minisystem/820/Panel/820_panel.png

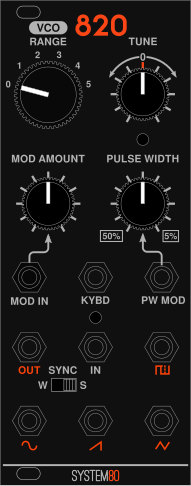
Panel/820_panel.png
