minisystem/820/Panel/Ward-Beck/820_panel_dimensioned.dxf

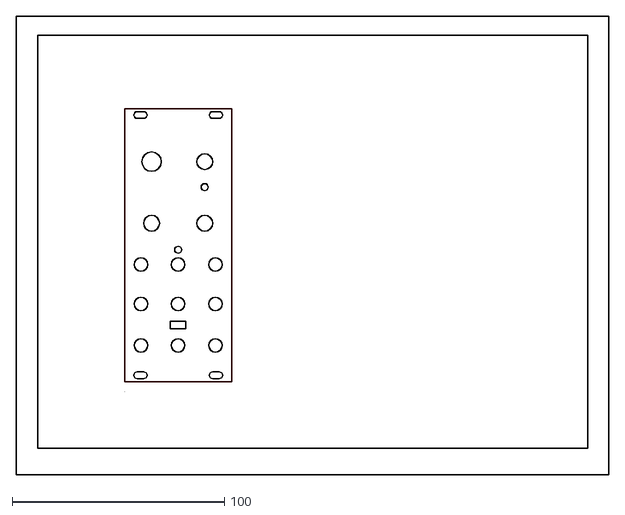
[picture p2: CAD file, 2019-03-22]
Panel/Ward-Beck/820_panel_dimensioned.dxf
279.0 x 216.0
