minisystem/820/panel_template.dxf

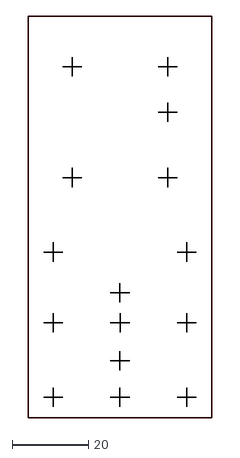
[picture p3: CAD file, 2018-07-26]
panel_template.dxf
48.0 x 105.0
