minisystem/820/(list of files, cad)

Other CAD files:
Panel/820_panel.dxf
Panel/820_panel_dimensioned.dwg
Panel/Ward-Beck/820_panel_dimensioned_R2000-2002.dwg
Panel/820_panel.dwg
Panel/Ward-Beck/820_panel_dimensioned.dwg
