minisystem/820/Panel/Ward-Beck/820_overview.pdf

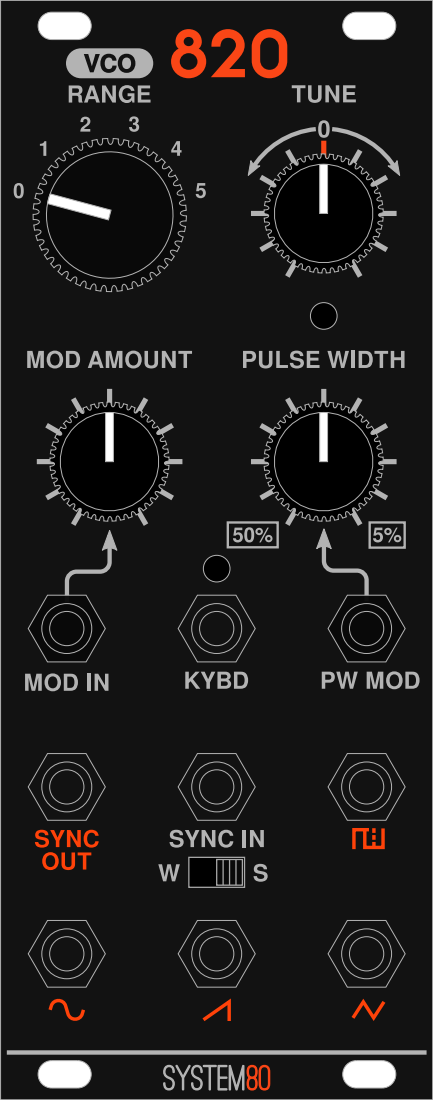
[picture p4: page 1]
