minisystem/820/Gerbers/820-Eco1.User.pdf

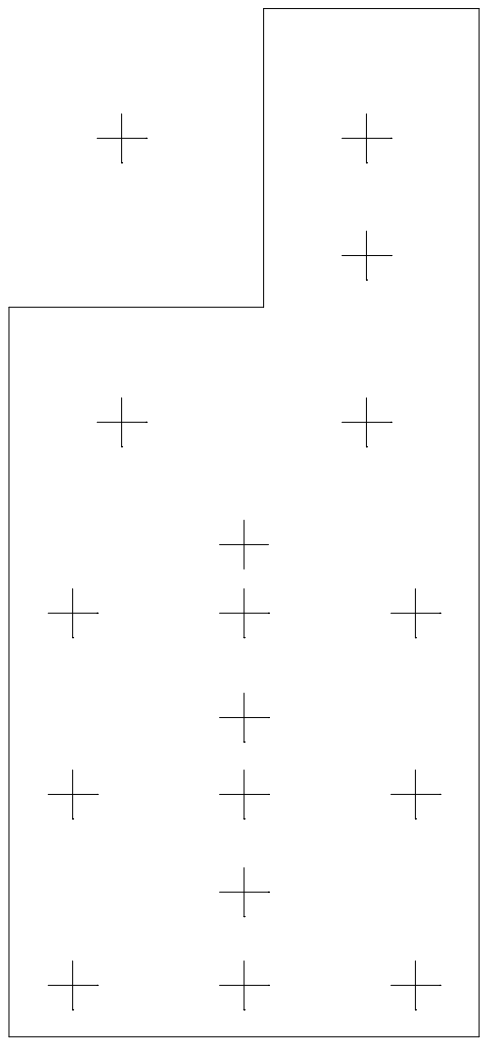
[picture p5: page 1]
