minisystem/820/Panel/Ward-Beck/820_artwork_grey.pdf

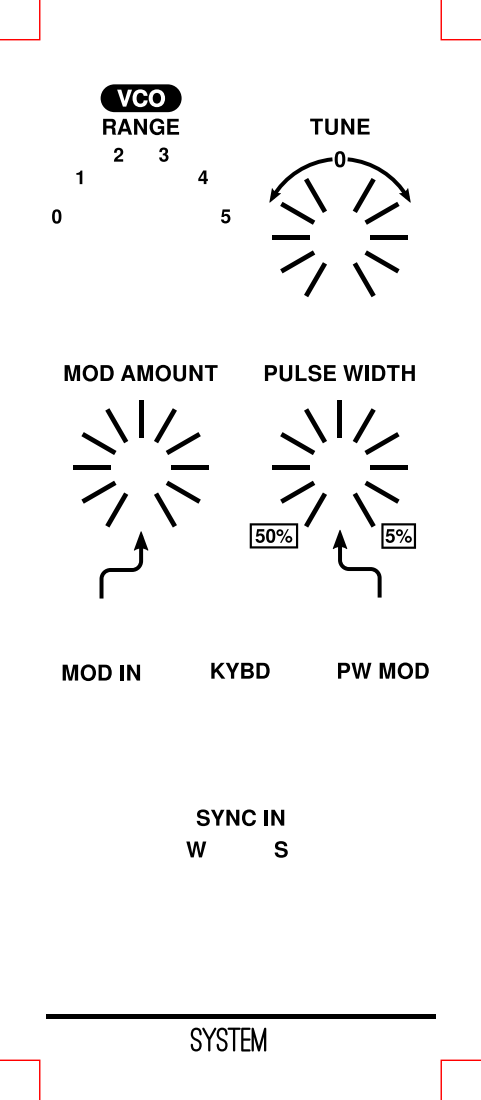
[picture p6: page 1]
