minisystem/820/Panel/Ward-Beck/820_artwork_orange.pdf

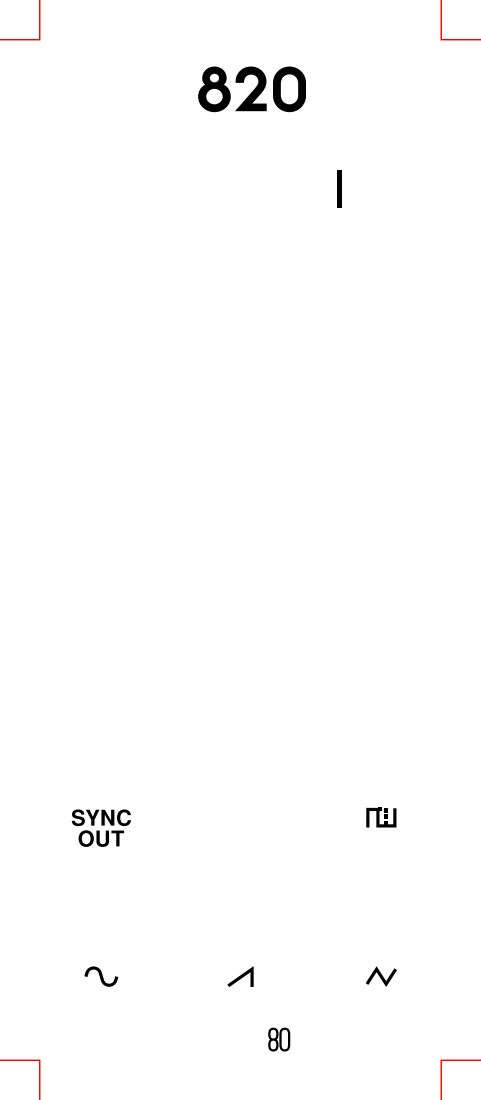
[picture p7: page 1]
