minisystem/820/Panel/Ward-Beck/820_panel_dimensioned.pdf

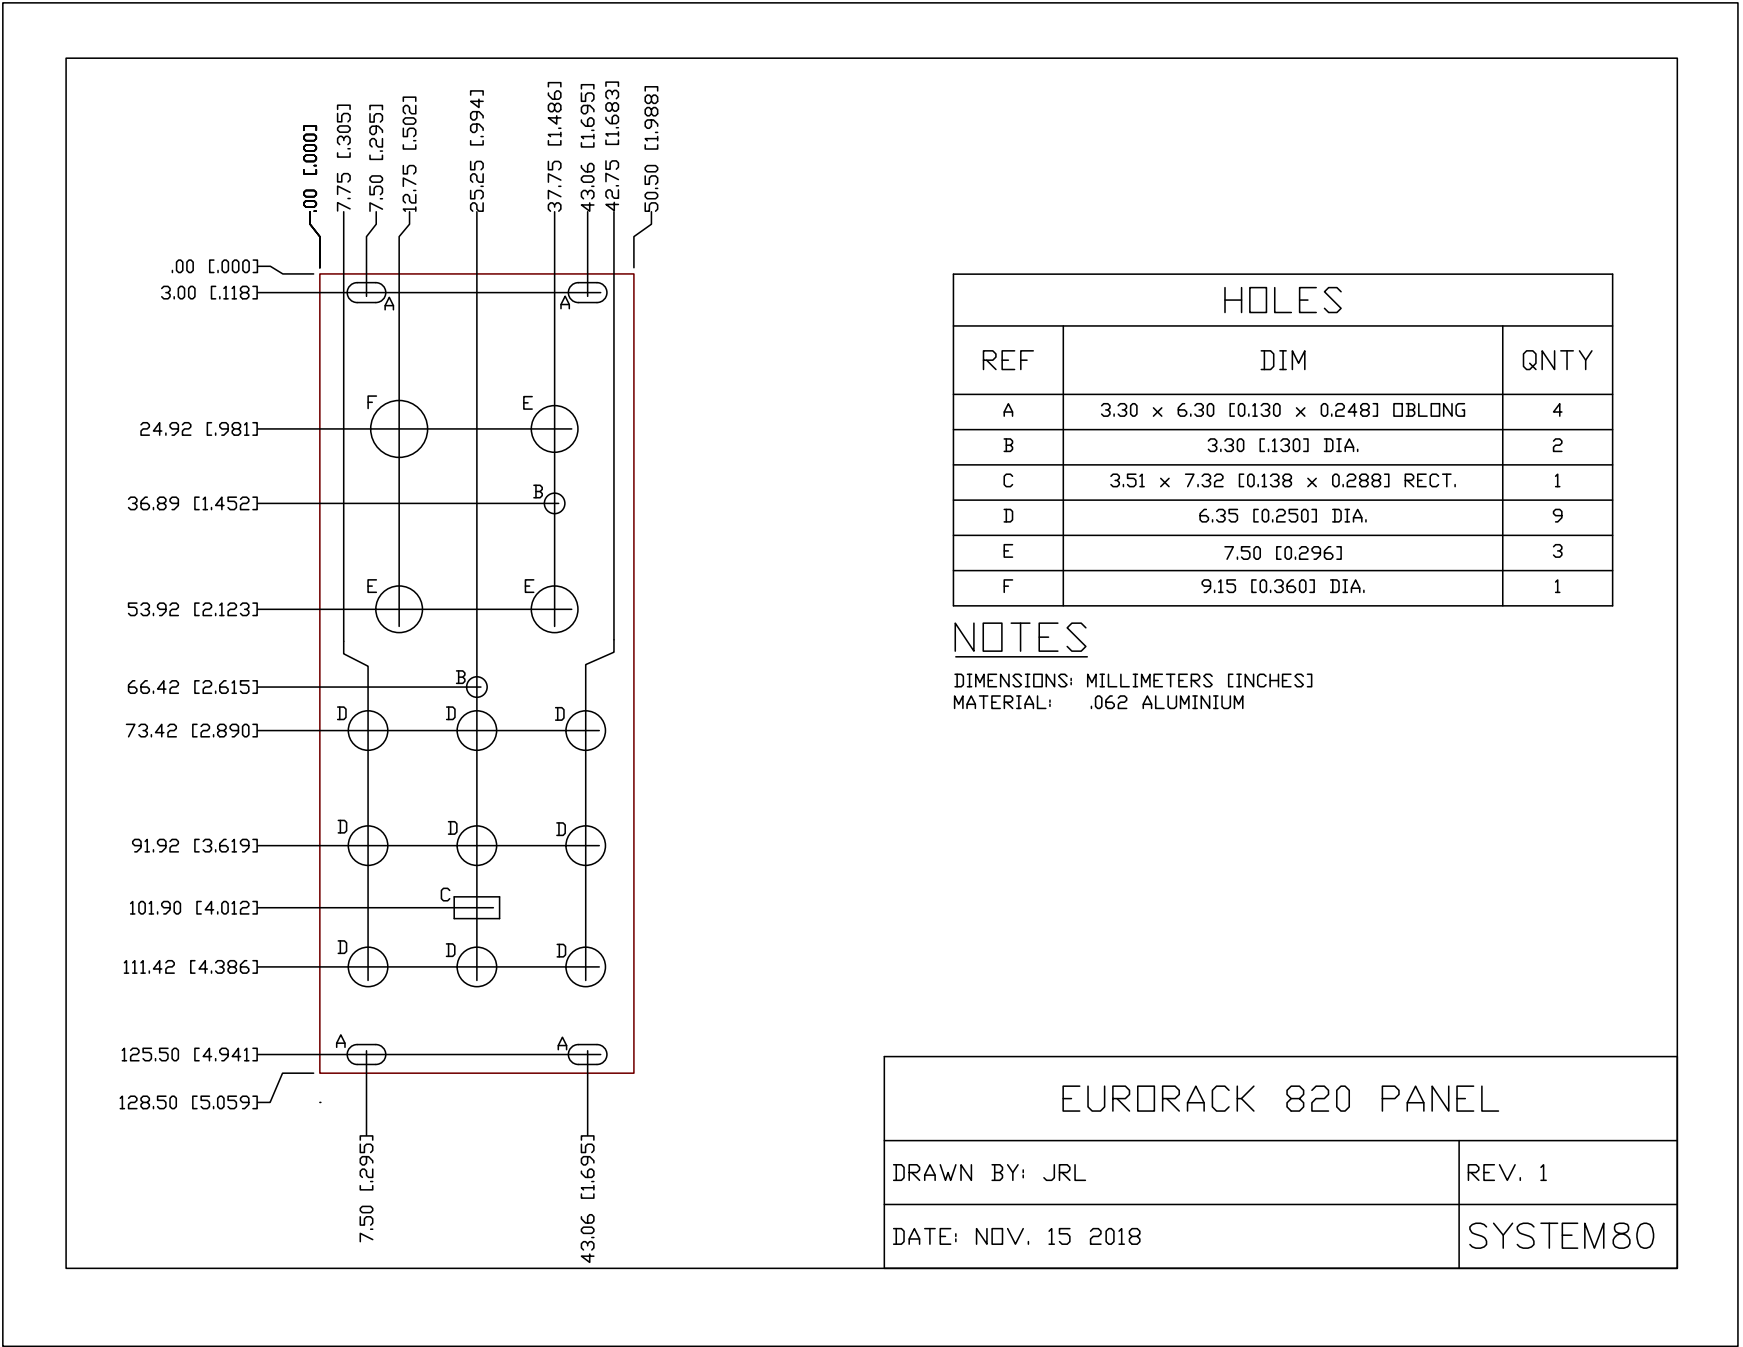
[picture p8: page 1]
