minisystem/820/820.kicad_pcb

## KiCad design 820.kicad_pcb (2019-04-12)

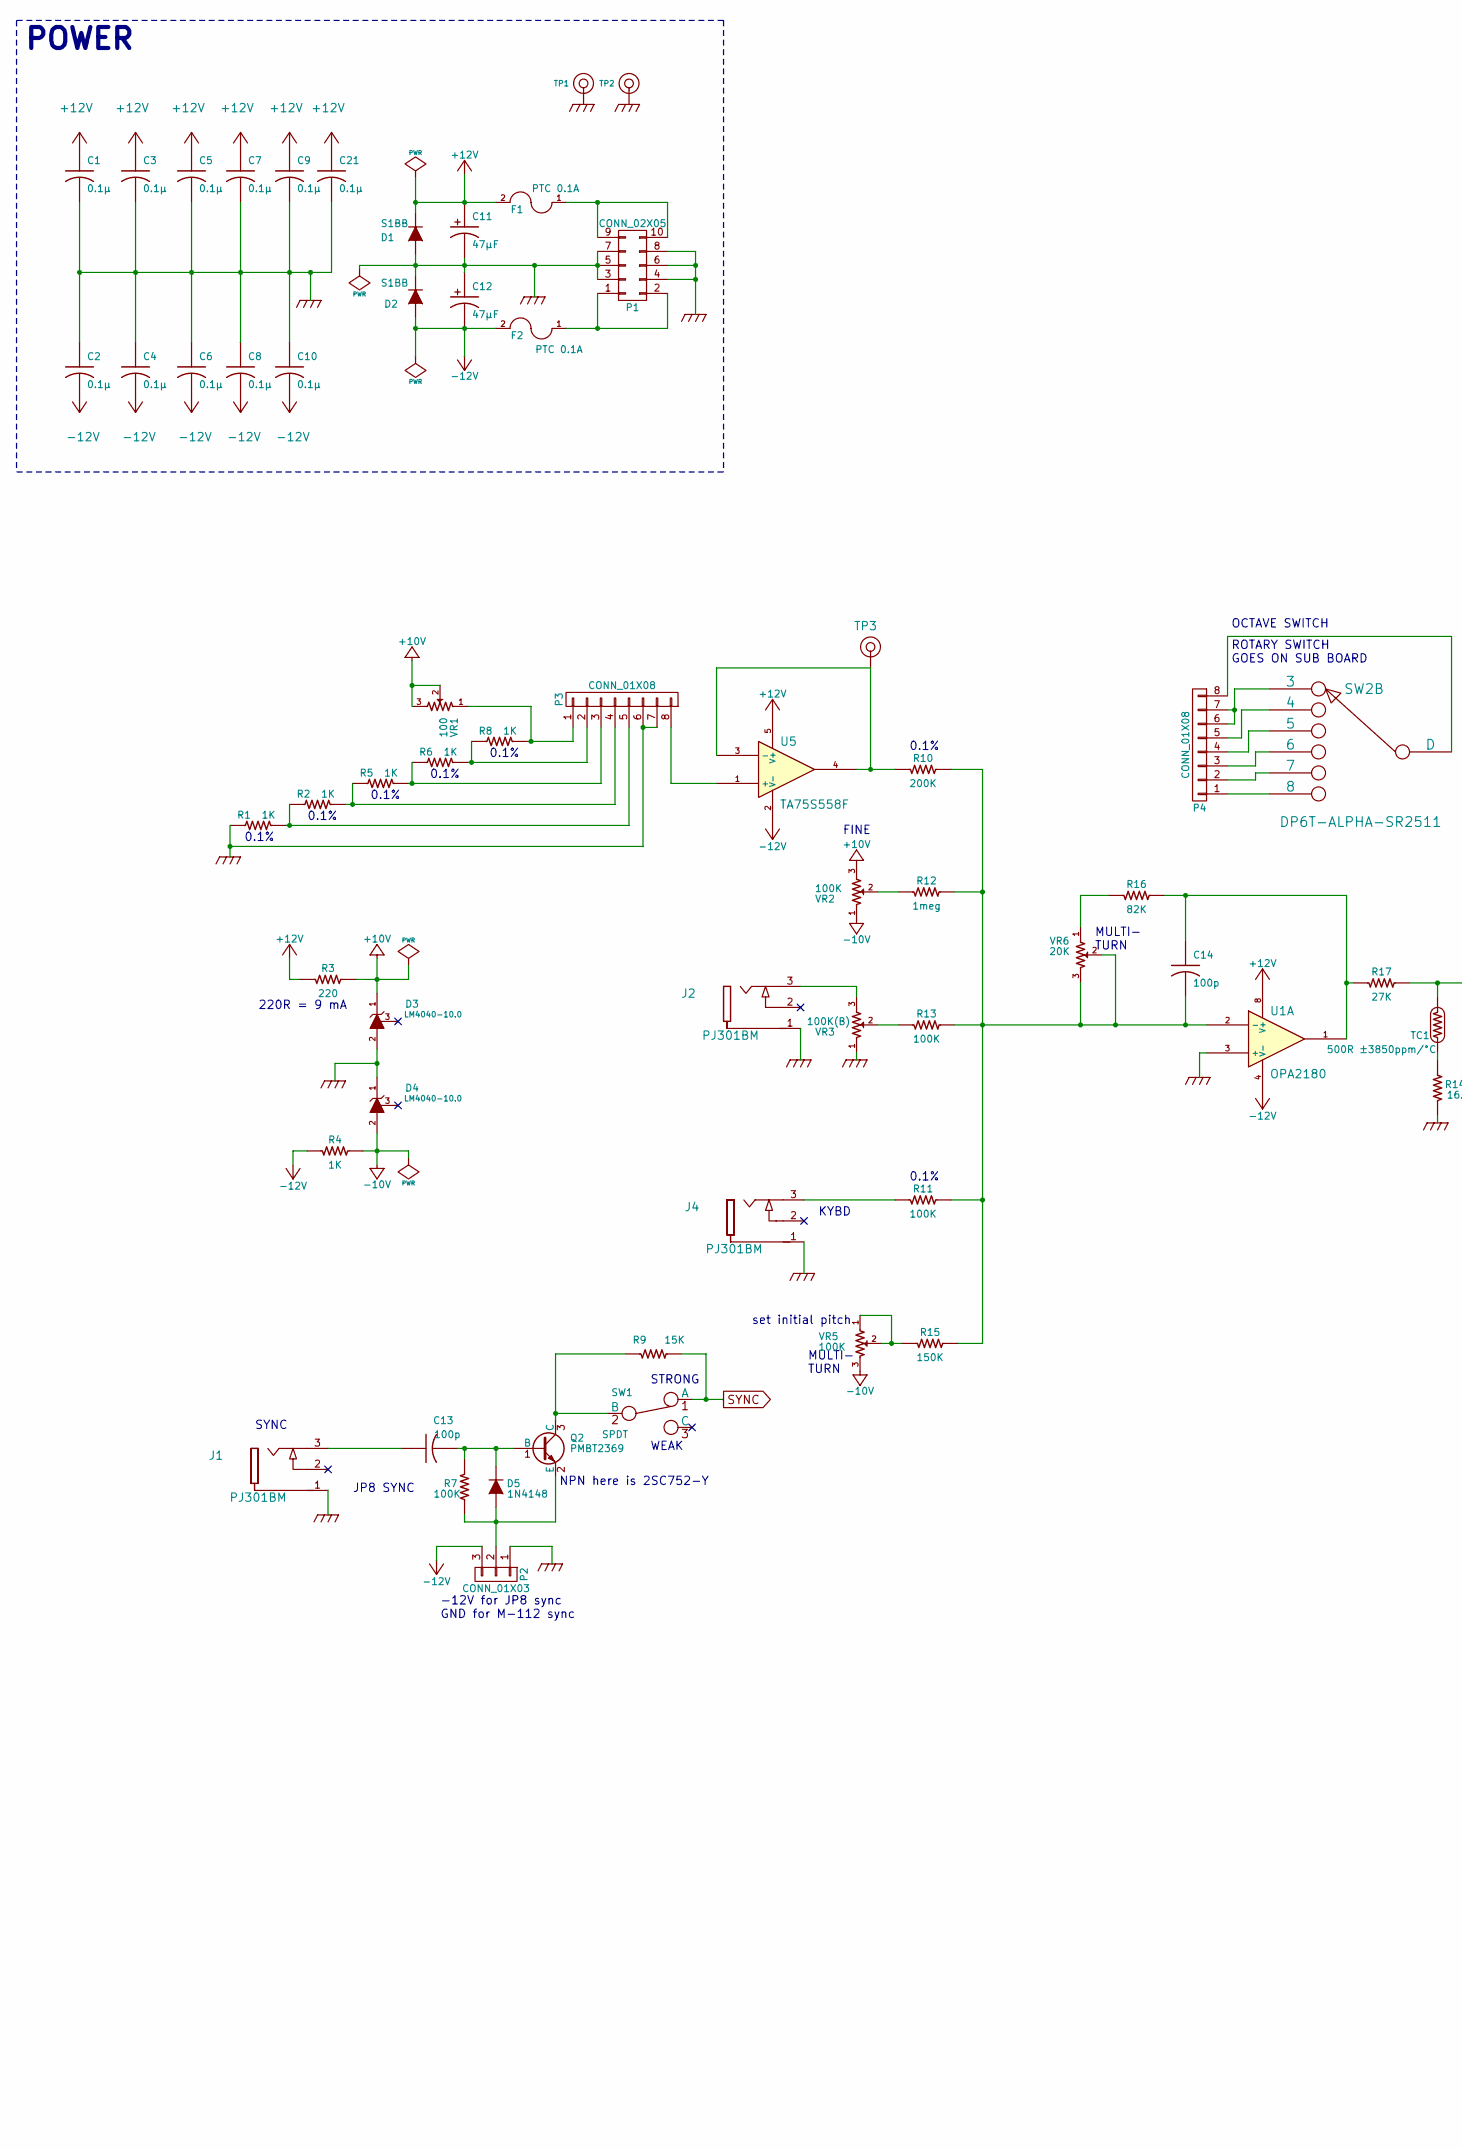
[picture p9: schematic 820.sch, part in row 1, column 1]

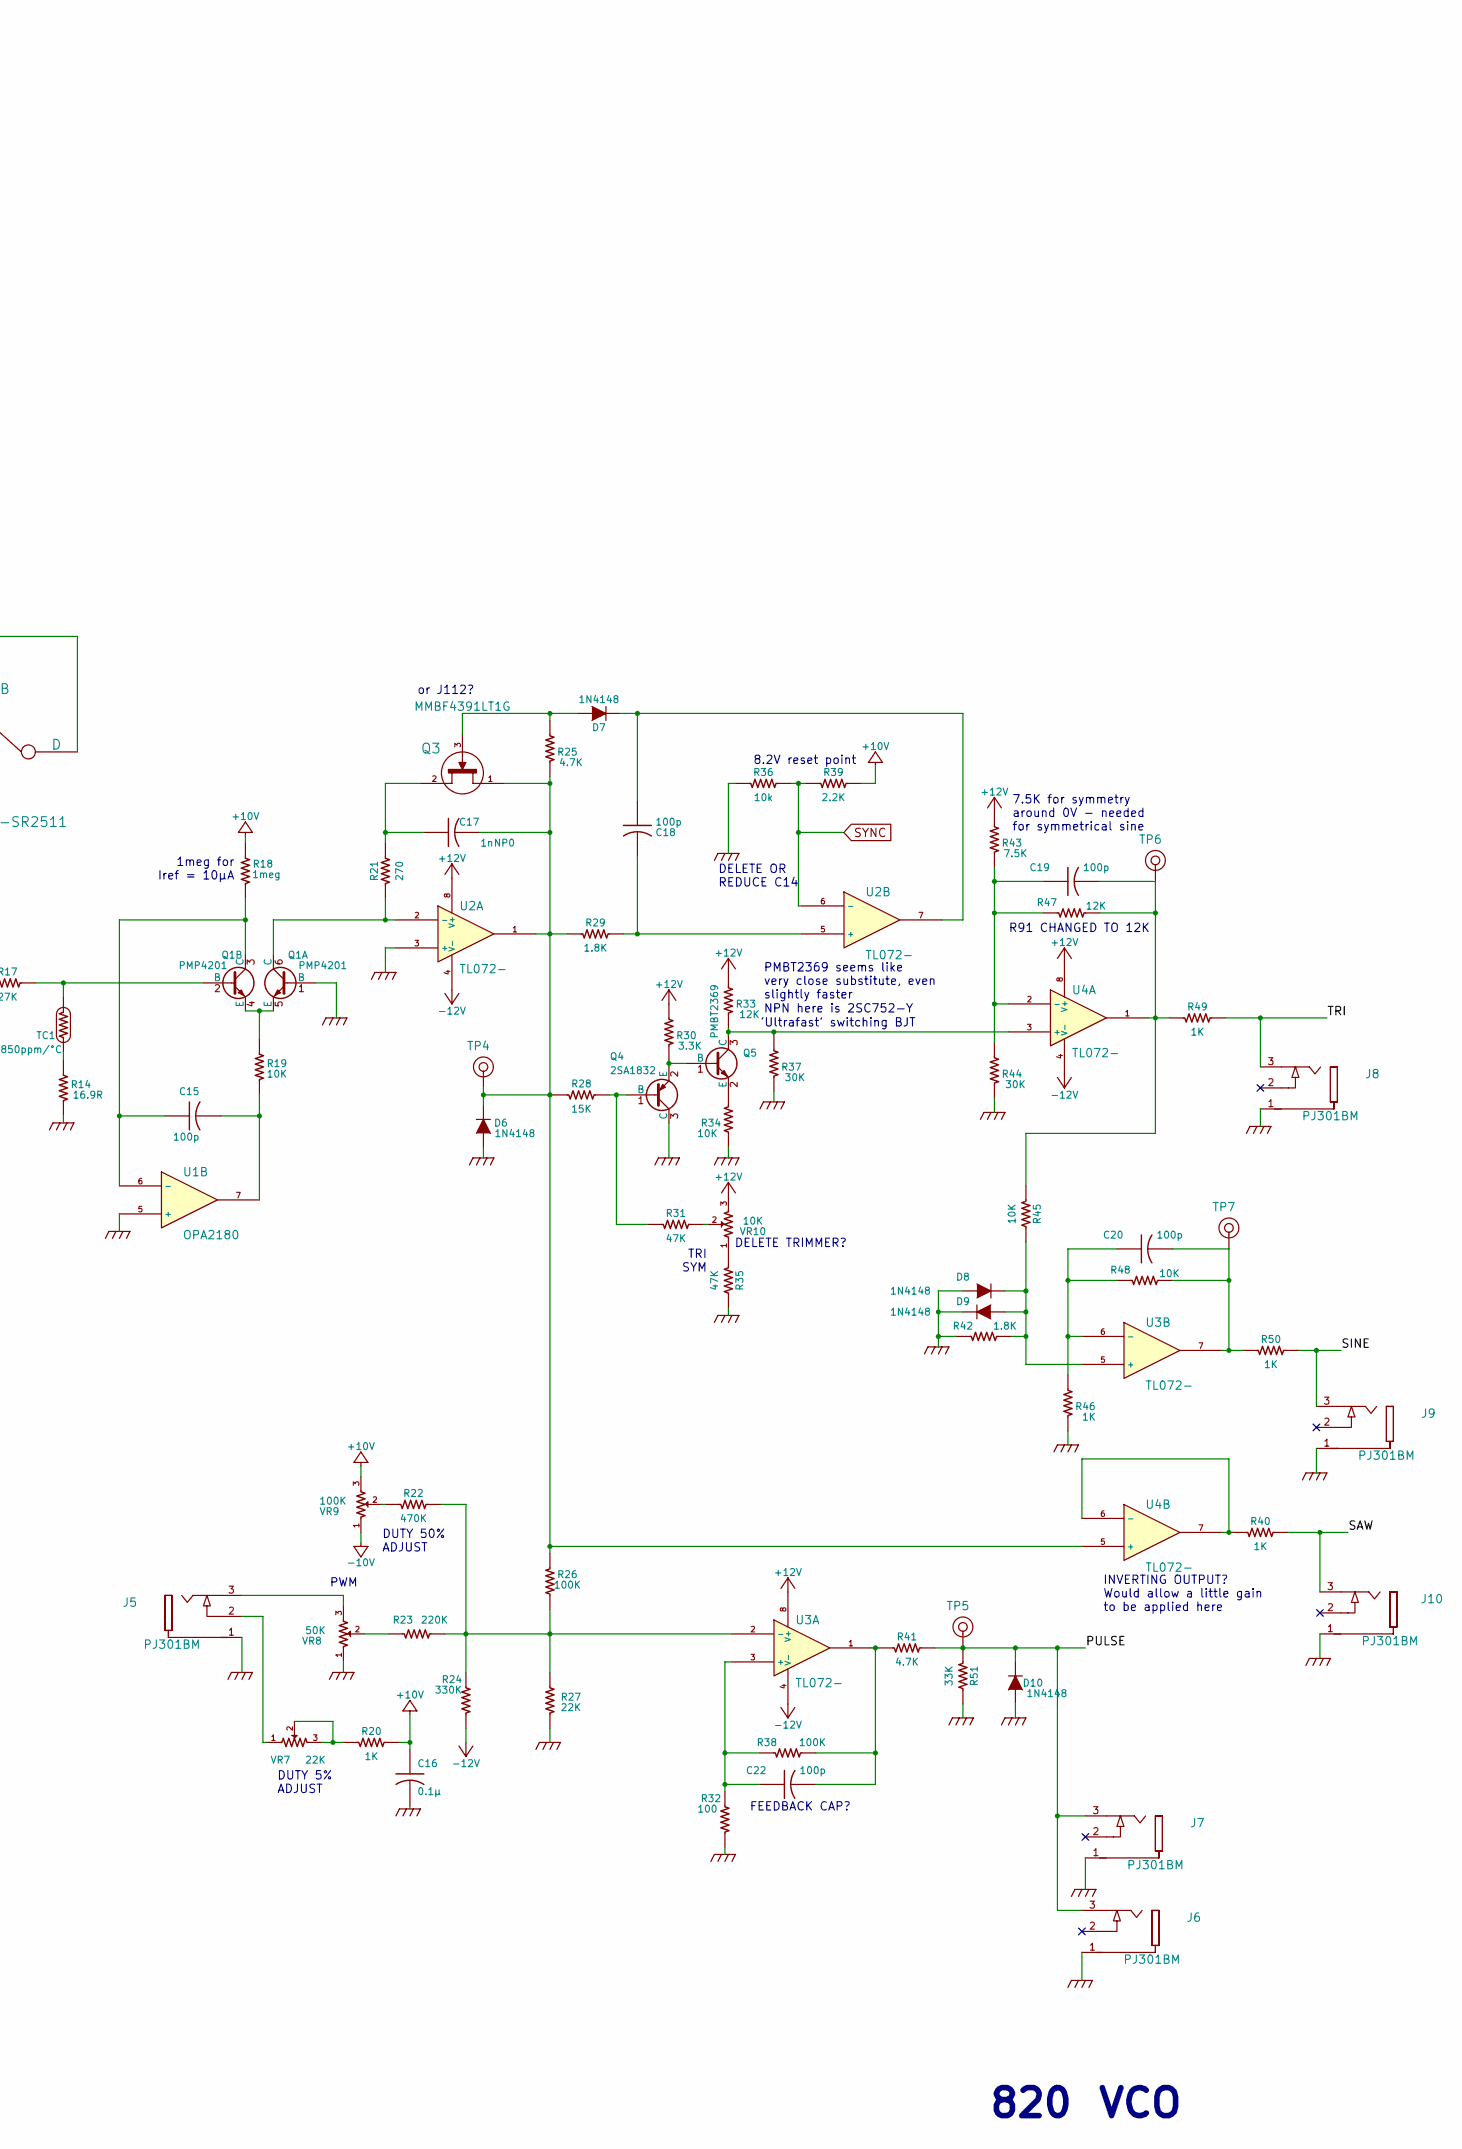
[picture p10: schematic 820.sch, part in row 1, column 2]

Parts:
C1, C2, C3, C4, C5, C6, C7, C8, C9, C10, C16, C21: 0.1µ; SM0603-C-JRL
C11, C12: 47μF; jrl_c_elec_5x5.3
C13, C18, C19, C20, C22: 100p; SM0603-C-JRL
C14, C15: 100p; SM0603-C-JRL; Digikey 399-1122-1-ND
C17: 1n; SM0603-C-JRL
D1, D2: S1BB; SMB-1C2A
D3, D4: LM4040-10.0; SOT23-132-JRL
D5, D6, D7, D8, D9, D10: 1N4148; SOD323-C1A2
F1, F2: PTC 0.1A; C_0805
J1, J2, J4, J5, J6, J7, J8, J9, J10: PJ301BM; PJ-301B-JACK-SLOTS
P1: CONN_02X05; Pin_Header_Straight_2x05_Pitch2.54mm
P2: CONN_01X03; Pin_Header_Straight_1x03_Pitch2.54mm
P3, P4: CONN_01X08; Pin_Header_Straight_1x08_Pitch2.54mm
Q1: PMP4201; SOT-666
Q2: PMBT2369; SOT-23
Q3: MMBF4391LT1G; SOT23-132-JRL
Q4: 2SA1832; SOT416-SC75
Q5: PMBT2369; SOT23-132-JRL
R1, R2, R5, R6, R8: 1K; SM0603-R-JRL
R3: 220; SM0603-R-JRL; Digikey P10.0KCCT-ND
R4, R20, R40, R46, R49, R50: 1K; SM0603-R-JRL; Digikey P10.0KCCT-ND
R7, R26, R38: 100K; SM0603-R-JRL; Digikey P10.0KCCT-ND
R9, R28: 15K; SM0603-R-JRL; Digikey P10.0KCCT-ND
R10: 200K; SM0603-R-JRL; Digikey P91.0KCCT-ND
R11, R13: 100K; SM0603-R-JRL; Digikey P91.0KCCT-ND
R12: 1meg; SM0603-R-JRL; Digikey P91.0KCCT-ND
R14: 16.9R; SM0603-R-JRL; Digikey P10.0KCCT-ND
R15: 150K; SM0603-R-JRL; Digikey P91.0KCCT-ND
R16: 82K; SM0603-R-JRL; Digikey P91.0KCCT-ND
R17: 27K; SM0603-R-JRL; Digikey P56.0KCCT-ND
R18: 1meg; SM0603-R-JRL; Digikey P1.50MCCT-ND
R19, R34, R45, R48: 10K; SM0603-R-JRL; Digikey P10.0KCCT-ND
R21: 270; SM0603-R-JRL; Digikey P10.0KCCT-ND
R22: 470K; SM0603-R-JRL; Digikey P10.0KCCT-ND
R23: 220K; SM0603-R-JRL; Digikey P10.0KCCT-ND
R24: 330K; SM0603-R-JRL; Digikey P10.0KCCT-ND
R25, R41: 4.7K; SM0603-R-JRL; Digikey P10.0KCCT-ND
R27: 22K; SM0603-R-JRL
R29, R42: 1.8K; SM0603-R-JRL; Digikey P10.0KCCT-ND
R30: 3.3K; SM0603-R-JRL; Digikey P10.0KCCT-ND
R31, R35: 47K; SM0603-R-JRL; Digikey P10.0KCCT-ND
R32: 100; SM0603-R-JRL; Digikey P10.0KCCT-ND
R33, R47: 12K; SM0603-R-JRL; Digikey P10.0KCCT-ND
R36: 10k; SM0603-R-JRL; Digikey P10.0KCCT-ND
R37, R44: 30K; SM0603-R-JRL; Digikey P10.0KCCT-ND
R39: 2.2K; SM0603-R-JRL; Digikey P10.0KCCT-ND
R43: 7.5K; SM0603-R-JRL; Digikey P10.0KCCT-ND
R51: 33K; SM0603-R-JRL; Digikey P10.0KCCT-ND
SW1: SPDT; SS-12F108-1P2T-SLIDE
SW2: DP6T-ALPHA-SR2511; SR2511-ALPHA
TC1: 500R ±3850ppm/°C; SM0603-R-JRL
TP1, TP2: CONN_1; TEST_POINT_LOOP_4592
TP3, TP4, TP5, TP6, TP7: TEST_POINT; TEST_POINT_5000_SERIES
U1: OPA2180; MSOP-8_3x3mm_Pitch0.65mm
U2, U3, U4: TL072-; TSSOP8-JRL
U5: TA75S558F; SOT753_TSOP5_SC-74A
VR1: 100; TC33X-2
VR2: 100K; RD901F-ALPHA-POT-T18
VR3: 100K(B); RD901F-ALPHA-POT-T18
VR5: 100K; Bourns-3296W
VR6: 20K; Bourns-3296W
VR7: 22K; TC33X-2
VR8: 50K; RD901F-ALPHA-POT-T18
VR9: 100K; TC33X-2
VR10: 10K; TC33X-2

Connections:
+10V: C16.1, D3.1 (K), R3.2, R18.2, R20.2, R39.2, VR1.2, VR1.3, VR2.3, VR9.3
+12V: C1.1, C3.1, C5.1, C7.1, C9.1, C11.1 (+), C21.1, D1.1 (K), F1.2, R3.1, R30.2, R33.2, R43.2, U1.8 (V+), U2.8 (V+), U3.8 (V+), U4.8 (V+), U5.5 (V+), VR10.3
-10V: D4.2 (A), R4.2, VR2.1, VR5.3, VR9.1
-12V: C2.2, C4.2, C6.2, C8.2, C10.2, C12.2 (-), D2.2 (A), F2.2, P2.3, R4.1, R24.2, U1.4 (V-), U2.4 (V-), U3.4 (V-), U4.4 (V-), U5.2 (V-)
/PULSE: D10.1 (K), J6.3, J7.3, R41.2, R51.1, TP5.1
/SAW: J10.3, R40.2
/SINE: J9.3, R50.2
/TRI: J8.3, R49.2
GND: C1.2, C2.1, C3.2, C4.1, C5.2, C6.1, C7.2, C8.1, C9.2, C10.1, C11.2 (-), C12.1 (+), C16.2, C21.2, D1.2 (A), D2.1 (K), D3.2 (A), D4.1 (K), D6.2 (A), D8.2 (A), D9.1 (K), D10.2 (A), J1.1, J2.1, J4.1, J5.1, J6.1, J7.1, J8.1, J9.1, J10.1, P1.3, P1.4, P1.5, P1.6, P1.7, P1.8, P2.1, P3.6, P3.7, Q1.1 (B), Q4.3 (C), R1.2, R14.1, R27.1, R32.2, R34.1, R35.1, R36.1, R37.1, R42.1, R44.1, R46.1, R51.2, TP1.1, TP2.1, U1.3 (+), U1.5 (+), U2.3 (+), VR3.1, VR8.1
unnamed: C13.1, J1.3
unnamed: C13.2, D5.1 (K), Q2.1 (B), R7.2
unnamed: C14.1, R16.2, R17.1, U1.1
unnamed: C14.2, R10.2, R11.2, R12.2, R13.2, R15.2, U1.2 (-), VR6.2, VR6.3
unnamed: C15.1, Q1.3 (C), R18.1, U1.6 (-)
unnamed: C15.2, R19.1, U1.7
unnamed: C17.1, Q3.2 (S), R21.2
unnamed: C17.2, D6.1 (K), Q3.1 (D), R25.1, R26.1, R28.1, R29.1, TP4.1, U2.1, U4.5 (+)
unnamed: C18.1, D7.1 (K), U2.7
unnamed: C18.2, R29.2, U2.5 (+)
unnamed: C19.1, R43.1, R44.2, R47.1, U4.2 (-)
unnamed: C19.2, R45.1, R47.2, R49.1, TP6.1, U4.1
unnamed: C20.1, R46.2, R48.1, U3.6 (-)
unnamed: C20.2, R48.2, R50.1, TP7.1, U3.7
unnamed: C22.1, R32.1, R38.1, U3.3 (+)
unnamed: C22.2, R38.2, R41.1, U3.1
unnamed: D5.2 (A), P2.2, Q2.2 (E), R7.1
unnamed: D7.2 (A), Q3.3 (G), R25.2
unnamed: D8.1 (K), D9.2 (A), R42.2, R45.2, U3.5 (+)
unnamed: F1.1, P1.9, P1.10
unnamed: F2.1, P1.1, P1.2
unnamed: J2.3, VR3.3
unnamed: J4.3, R11.1
unnamed: J5.2, VR7.1
unnamed: J5.3, VR8.3
unnamed: P3.1, R8.1, VR1.1
unnamed: P3.2, R6.1, R8.2
unnamed: P3.3, R5.1, R6.2
unnamed: P3.4, R2.1, R5.2
unnamed: P3.5, R1.1, R2.2
unnamed: P3.8, U5.1 (+)
unnamed: P4.1, SW2.8
unnamed: P4.2, SW2.7
unnamed: P4.3, SW2.6
unnamed: P4.4, SW2.5
unnamed: P4.5, SW2.4
unnamed: P4.6, P4.7, SW2.3
unnamed: P4.8, SW2.D
unnamed: Q1.2 (B), R17.2, TC1.1
unnamed: Q1.4 (E), Q1.5 (E), R19.2
unnamed: Q1.6 (C), R21.1, U2.2 (-)
unnamed: Q2.3 (C), R9.1, SW1.2 (B)
unnamed: Q4.1 (B), R28.2, R31.2
unnamed: Q4.2 (E), Q5.1 (B), R30.1
unnamed: Q5.2 (E), R34.2
unnamed: Q5.3 (C), R33.1, R37.2, U4.3 (+)
unnamed: R10.1, TP3.1, U5.3 (-), U5.4
unnamed: R12.1, VR2.2
unnamed: R13.1, VR3.2
unnamed: R14.2, TC1.2
unnamed: R15.1, VR5.1, VR5.2
unnamed: R16.1, VR6.1
unnamed: R20.1, VR7.2, VR7.3
unnamed: R22.1, VR9.2
unnamed: R22.2, R23.2, R24.1, R26.2, R27.2, U3.2 (-)
unnamed: R23.1, VR8.2
unnamed: R31.1, VR10.2
unnamed: R35.2, VR10.1
unnamed: R40.1, U4.6 (-), U4.7
SYNC: R9.2, R36.2, R39.1, SW1.1 (A), U2.6 (-)

Notes on the sheet:
or J112?
VCO
NPN here is 2SC752-Y
8.2V reset point
'Ultrafast' switching BJT
PMBT2369 seems like very close substitute, even slightly faster
MULTI- TURN
set initial pitch
FINE
DUTY 50% ADJUST
DUTY 5% ADJUST
PWM
SYNC
ROTARY SWITCH GOES ON SUB BOARD
JP8 SYNC
WEAK
STRONG
-12V for JP8 sync GND for M-112 sync
OCTAVE SWITCH
TRI SYM
DELETE TRIMMER?
DELETE OR REDUCE C14
220R = 9 mA
0.1%
1meg for Iref = 10µA
R91 CHANGED TO 12K
7.5K for symmetry around 0V - needed for symmetrical sine
POWER
KYBD
820
INVERTING OUTPUT? Would allow a little gain to be applied here
FEEDBACK CAP?

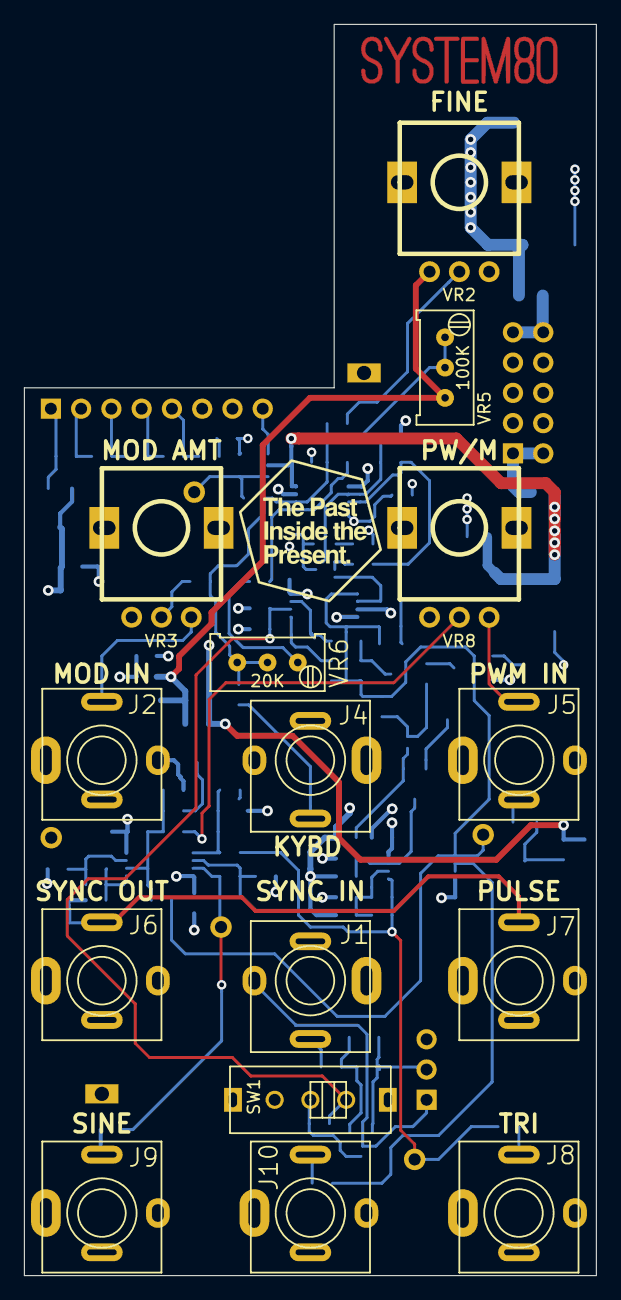
[picture p11: board 820.kicad_pcb from above]

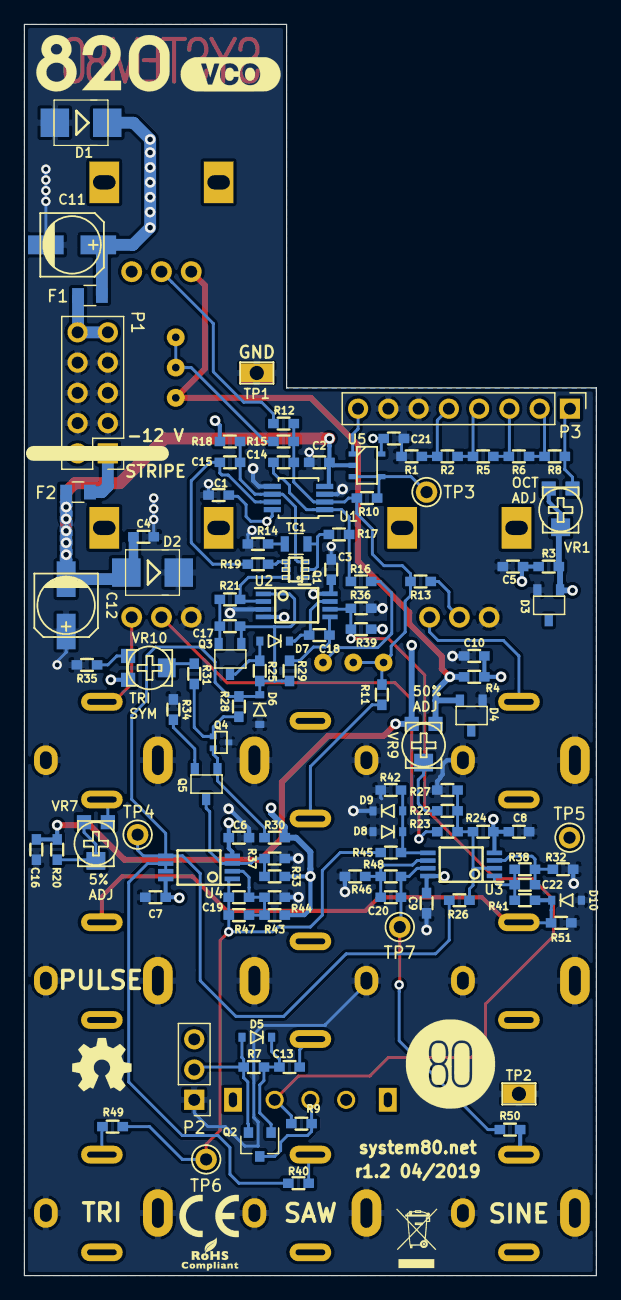
[picture p12: board 820.kicad_pcb from below]

Board: 4 copper layers, 48.0 x 105.0 mm, 125 parts (110 on the bottom side), 62 nets.
