minisystem/820/(commit log)

2018-07-26 starting to place and route
    [820.sch, panel_template.dxf]
2018-07-27 mostly placed
    [820.kicad_pcb, 820.sch]
2018-07-30 routed, except for rotary switch on separate daughter board
    [820.kicad_pcb]
2018-07-30 separated rotary switch daughter board, finished routing
    [820.kicad_pcb, 820.sch, 820_rotary_switch.kicad_pcb]
2018-08-02 bit of tweaking, need to start placing references
    [820.kicad_pcb, 820.sch]
2018-08-28 arranged silk screen references
    [820.kicad_pcb]
2018-10-21 fixed incorrect pin on switch board: 9 was connected instead of 8
    [820.kicad_pcb, 820.sch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]
2018-10-24 changed 2SC4207 NPN pair to BCM847 matched pair.
    [820.kicad_pcb, 820.sch]
2018-10-31 PMP4201 NPN matched pair replaces BCM847
    [820.kicad_pcb, 820.sch]
2018-11-20 adding panel files
    [820_panel.dxf, 820_panel_dimensioned.dwg, 820_panel_dimensioned.dxf, 820_panel_dimensioned_R2000-2002.dwg]
2019-03-22 first commit in a while. switched matched pair to PMP and other stuff. getting ready to order r1.1
    [820.kicad_pcb, 820.sch, 820_panel.dwg, 820_panel.dxf, 820_panel_dimensioned.dwg]
2019-03-27 updates for final prototype, changed matched pair back to SOT-363
    [820.kicad_pcb, 820.sch]
2019-03-28 gerbers ready to submit to pcb fab house. need to generate gerbers for rotary switch board still
    [820-B.Cu.gbl, 820-B.Mask.gbs, 820-B.SilkS.gbo, 820-Edge.Cuts.gm1, 820-F.Cu.gtl, 820-F.Mask.gts, 820-F.SilkS.gto, 820.drl]
2019-04-12 final prototype ordred, built and tested, committing now and then branching to panelization
    [820-B.Cu.gbl, 820-B.Mask.gbs, 820-B.SilkS.gbo, 820-Edge.Cuts.gm1, 820-F.Cu.gtl, 820-F.Mask.gts, 820-F.SilkS.gto, 820.drl]
2019-04-12 added panelized PCB
    [panelized.kicad_pcb]
2019-04-13 edits to panelized, fiduicals and border added
    [panelized.kicad_pcb]
